alibeknakhimov/Naiza-Boxer/hardware/controller-board/PCB_NAIZA_CONTROLLER.png

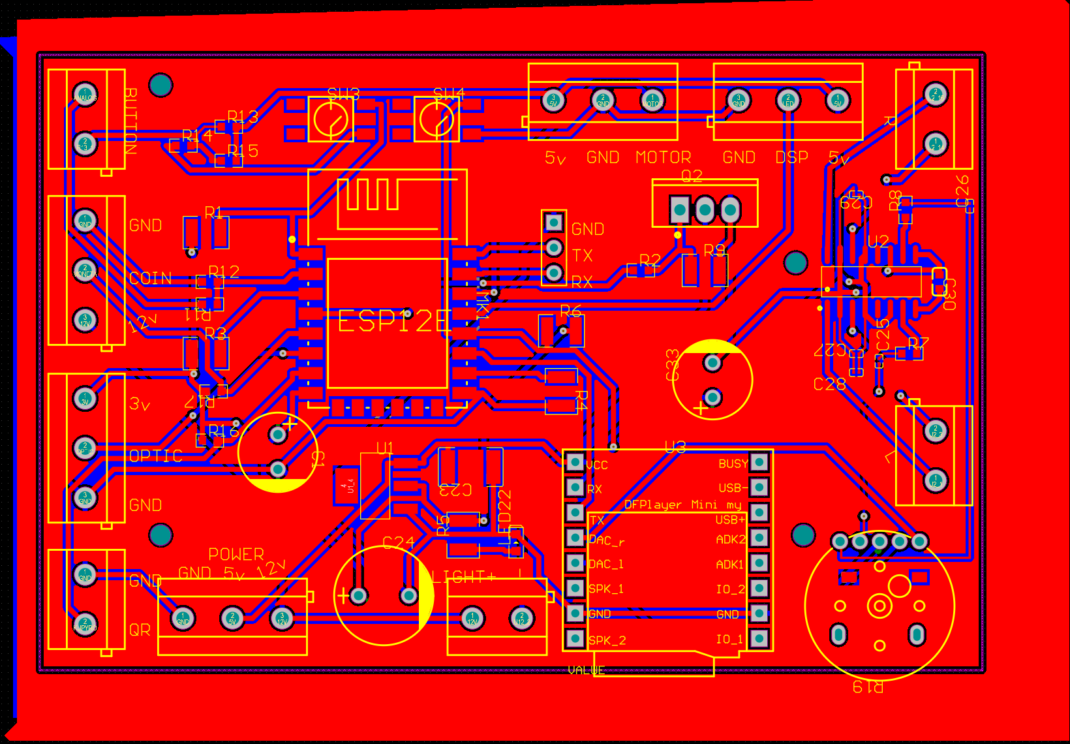
hardware/controller-board/PCB_NAIZA_CONTROLLER.png
