alibeknakhimov/Naiza-Boxer/hardware/display-board/PCB_boxDisp.png

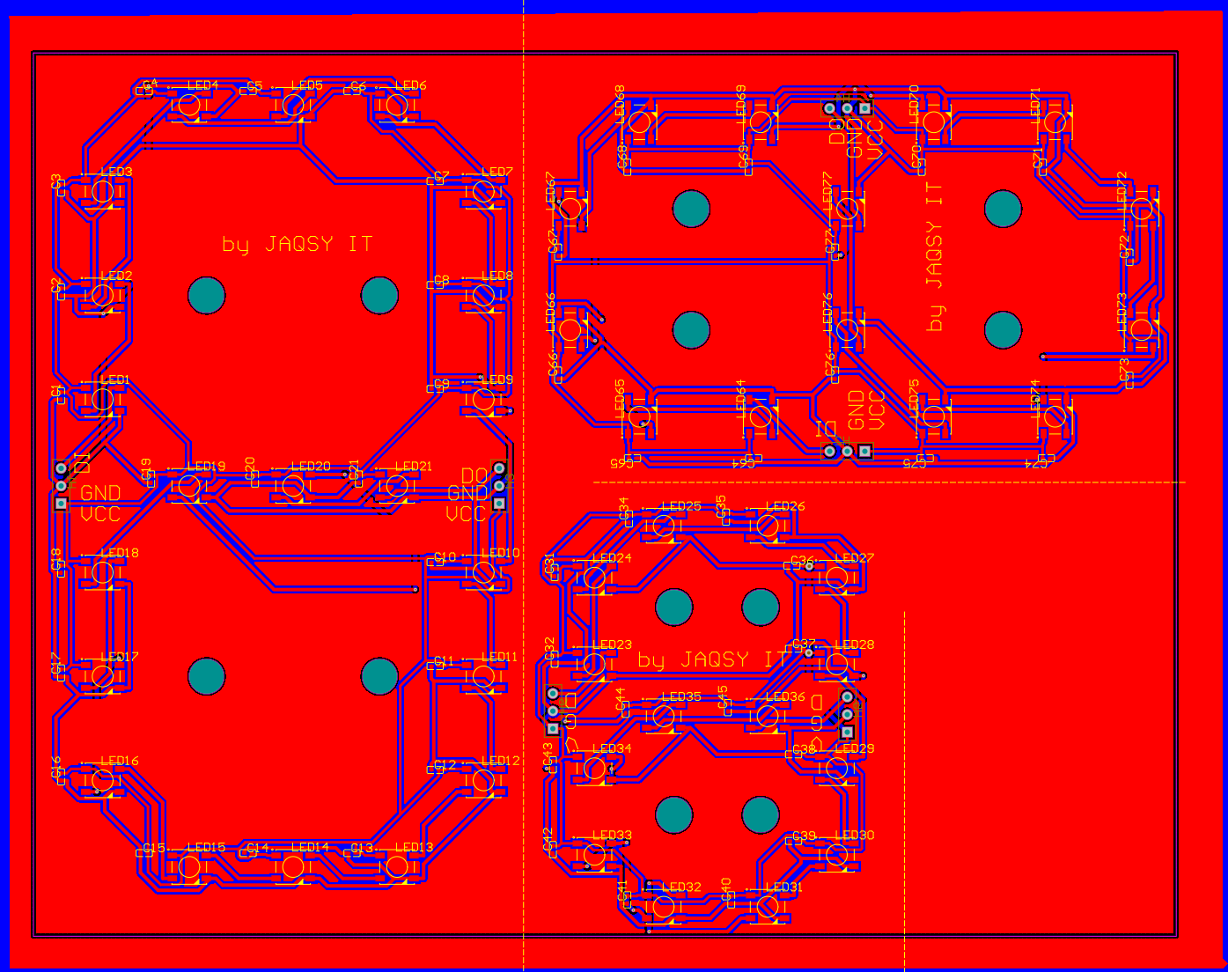
hardware/display-board/PCB_boxDisp.png
