alibeknakhimov/Naiza-Boxer/media/photos/3F5CE515-B64C-4980-AA3E-3DC91DD8F0C6.jpg

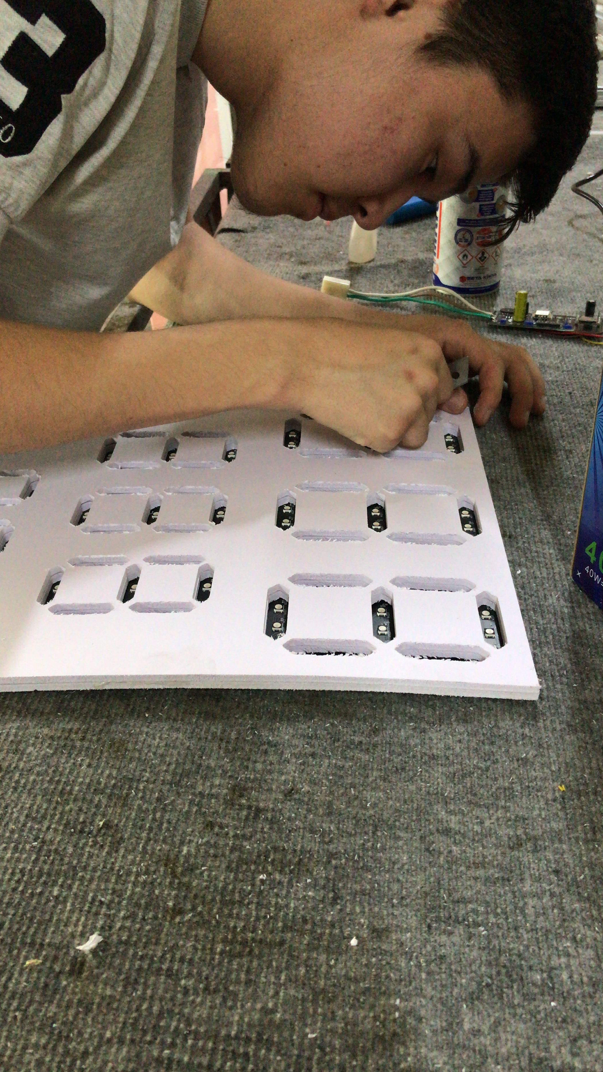
media/photos/3F5CE515-B64C-4980-AA3E-3DC91DD8F0C6.jpg
