alibeknakhimov/Naiza-Boxer/media/photos/20220618_153551.jpg

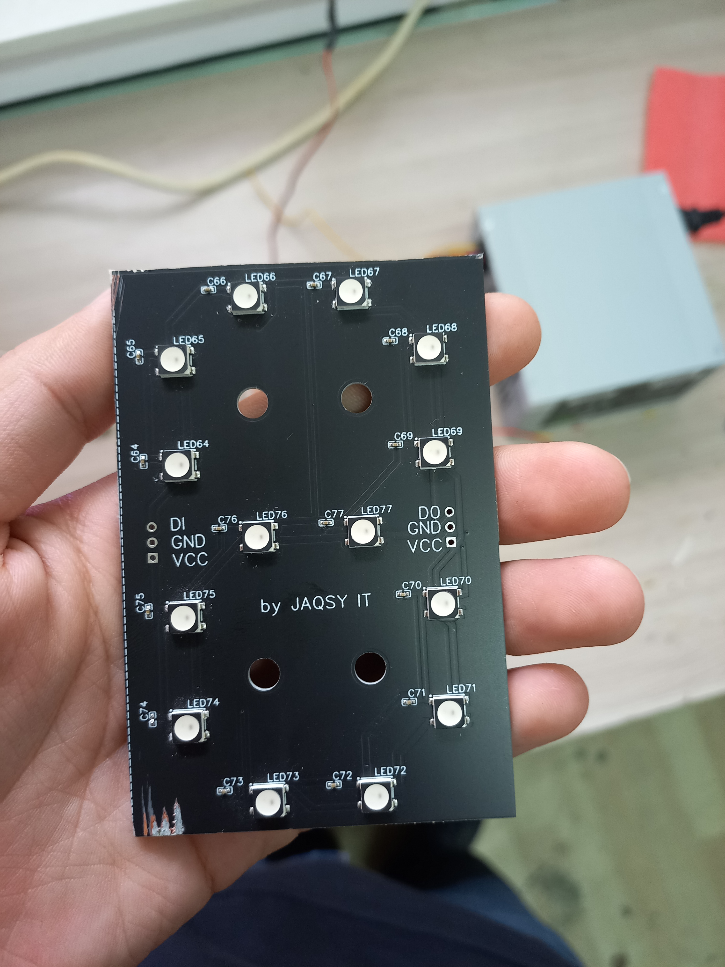
media/photos/20220618_153551.jpg
