alibeknakhimov/Naiza-Boxer/media/photos/20220618_153646.jpg

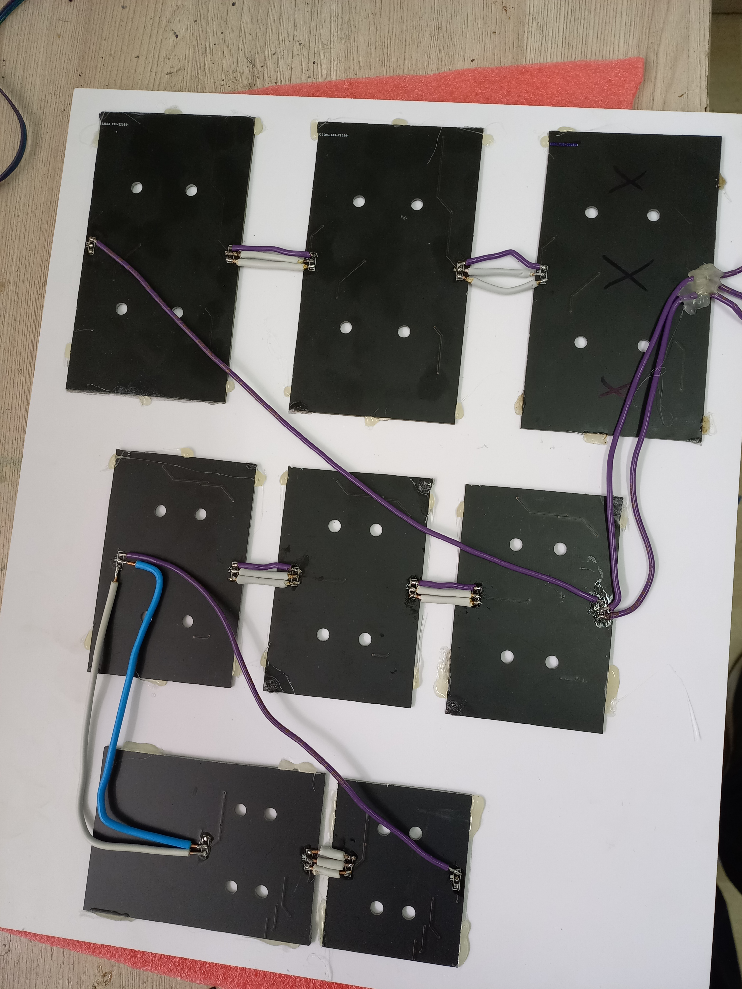
media/photos/20220618_153646.jpg
