alibeknakhimov/Naiza-Boxer/media/photos/AF380AF1-BA0E-4150-B0BB-21EFCCC5D488.jpg

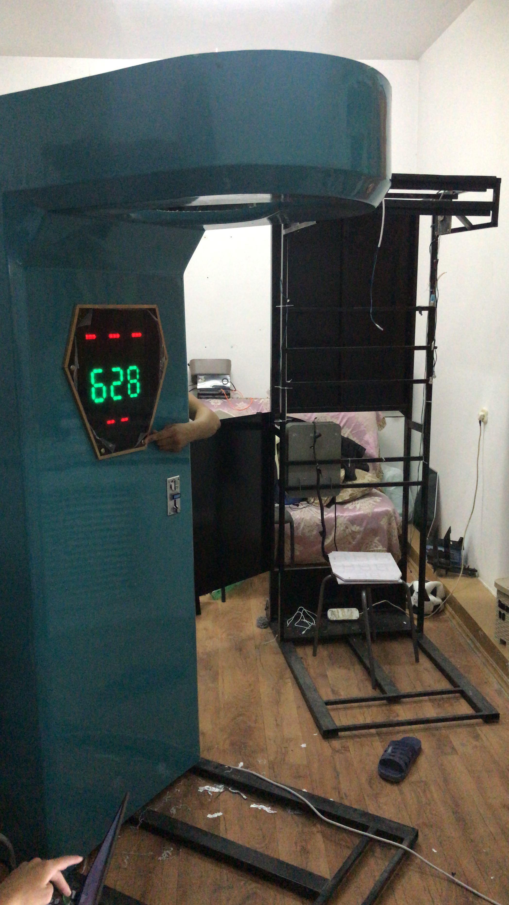
media/photos/AF380AF1-BA0E-4150-B0BB-21EFCCC5D488.jpg
