alibeknakhimov/Naiza-Boxer/media/photos/IMG-20220126-WA0025.jpg

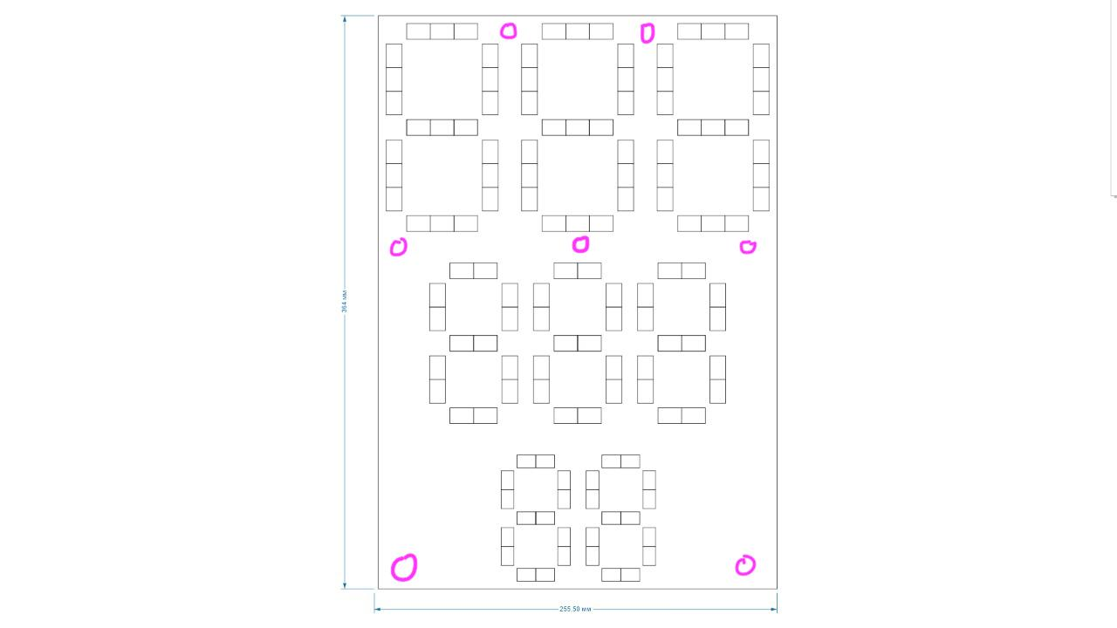
media/photos/IMG-20220126-WA0025.jpg
