alibeknakhimov/Naiza-Boxer/media/photos/IMG-20220317-WA0033.jpg

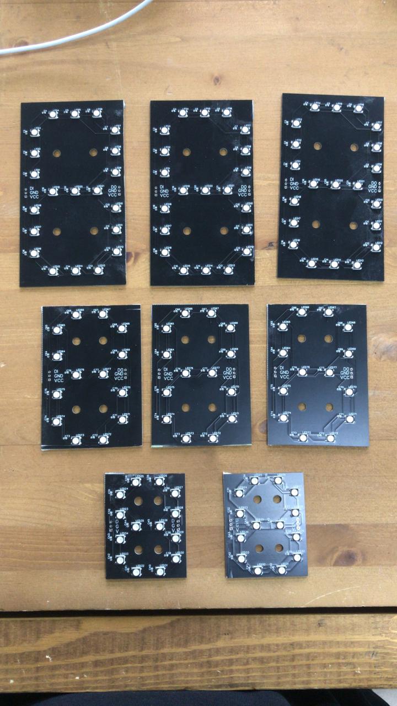
media/photos/IMG-20220317-WA0033.jpg
