alibeknakhimov/Naiza-Boxer/media/photos/IMG-20220427-WA0114.jpeg

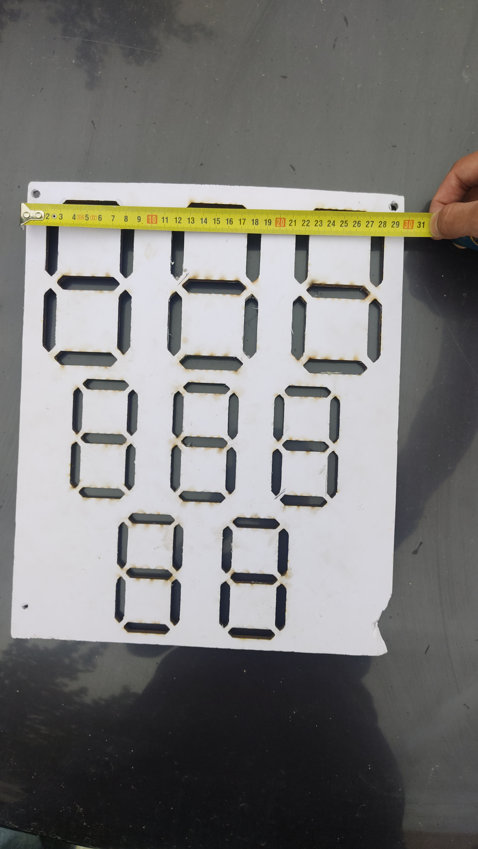
media/photos/IMG-20220427-WA0114.jpeg
