alibeknakhimov/Naiza-Boxer/media/photos/IMG-20220427-WA0122.jpeg

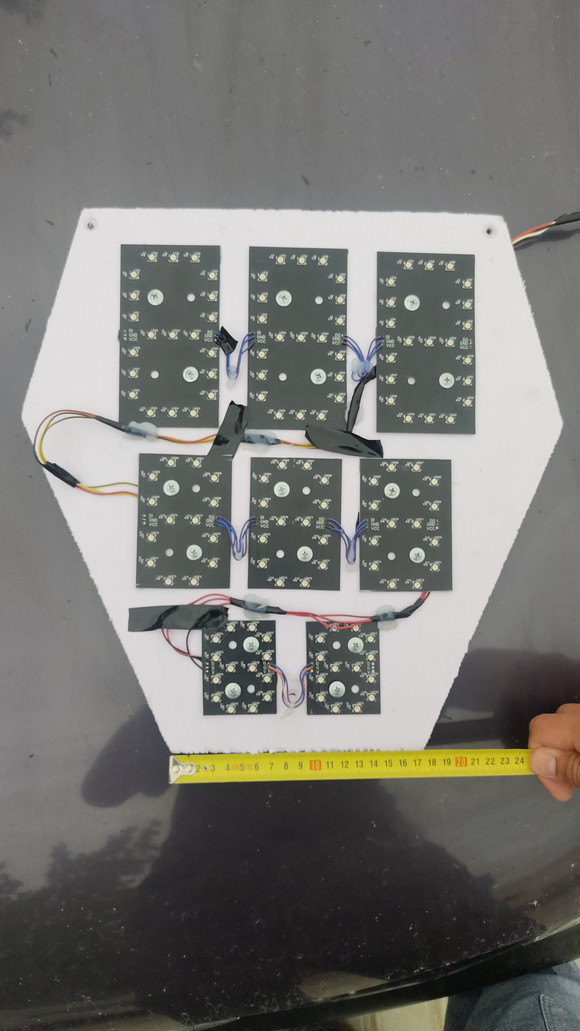
media/photos/IMG-20220427-WA0122.jpeg
