alibeknakhimov/Naiza-Boxer/media/photos/IMG-20220718-WA0063.jpg

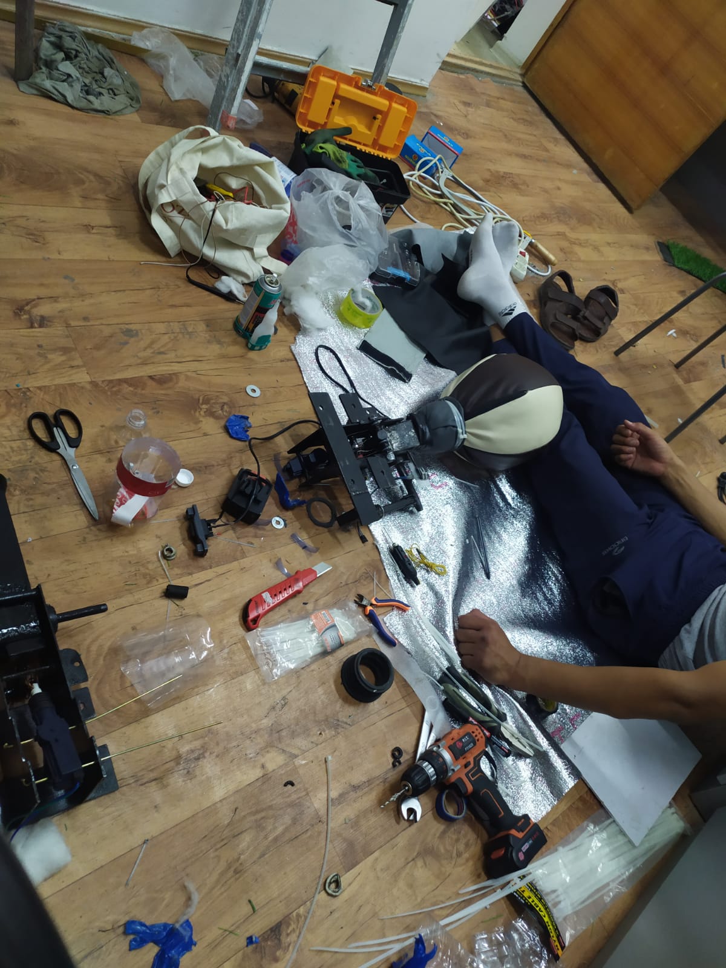
media/photos/IMG-20220718-WA0063.jpg
