alibeknakhimov/Naiza-Boxer/media/photos/IMG-20230116-WA0098.jpg

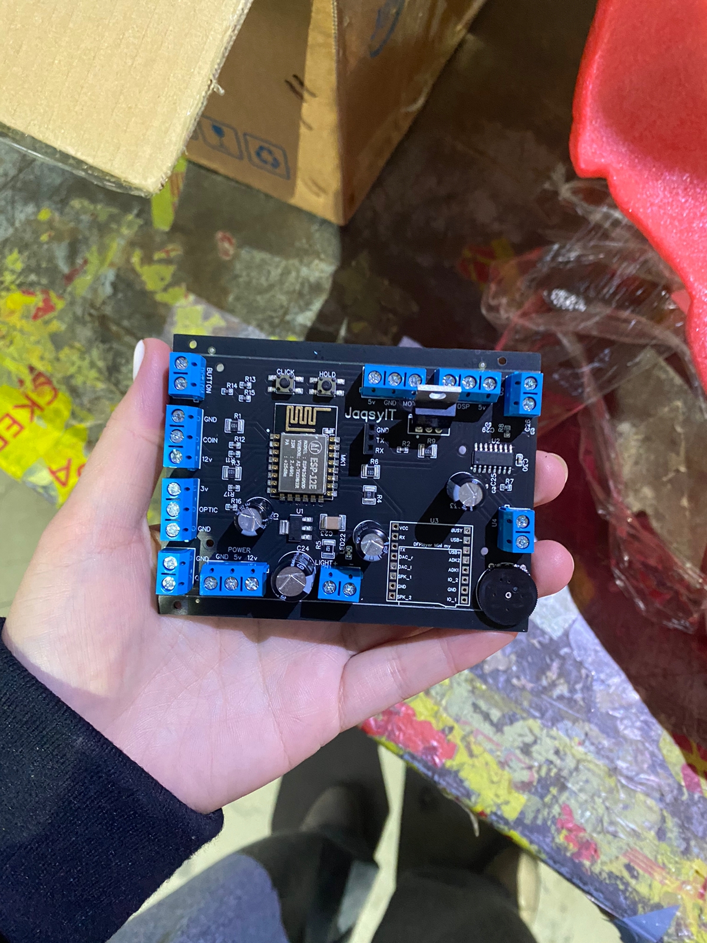
media/photos/IMG-20230116-WA0098.jpg
