alibeknakhimov/Naiza-Boxer/media/photos/IMG_2034.jpg

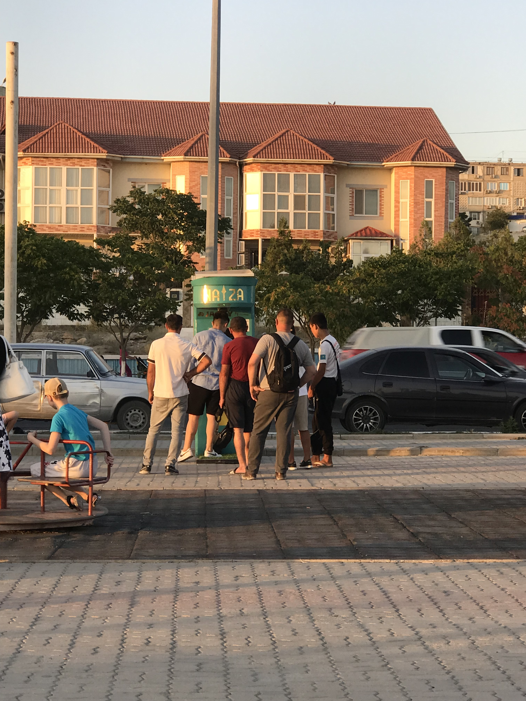
media/photos/IMG_2034.jpg
