alibeknakhimov/Naiza-Boxer/media/photos/IMG_3334.jpg

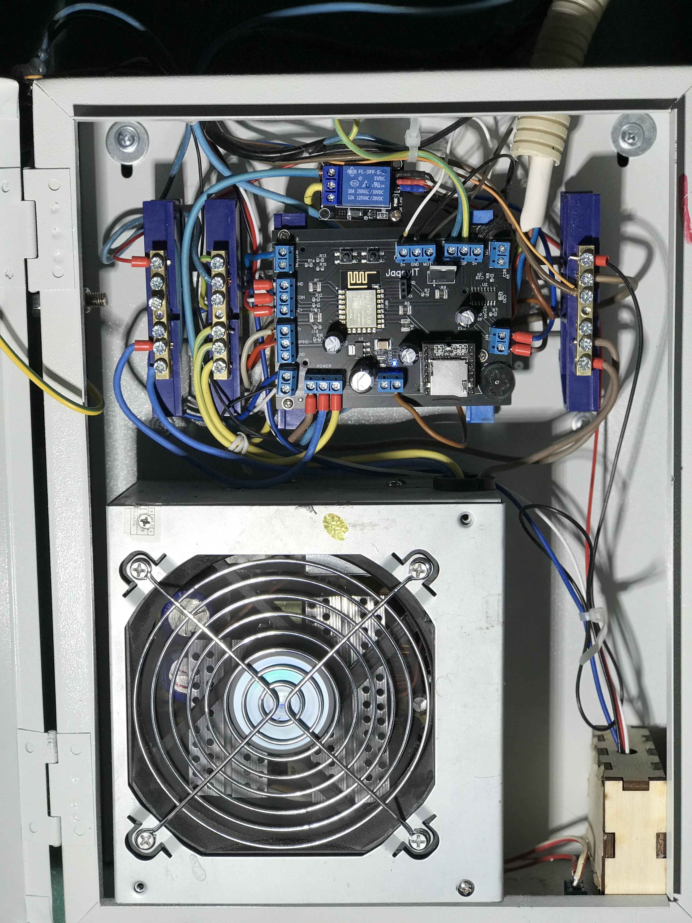
media/photos/IMG_3334.jpg
