alibeknakhimov/Naiza-Boxer/media/photos/IMG_20230424_165639.jpg

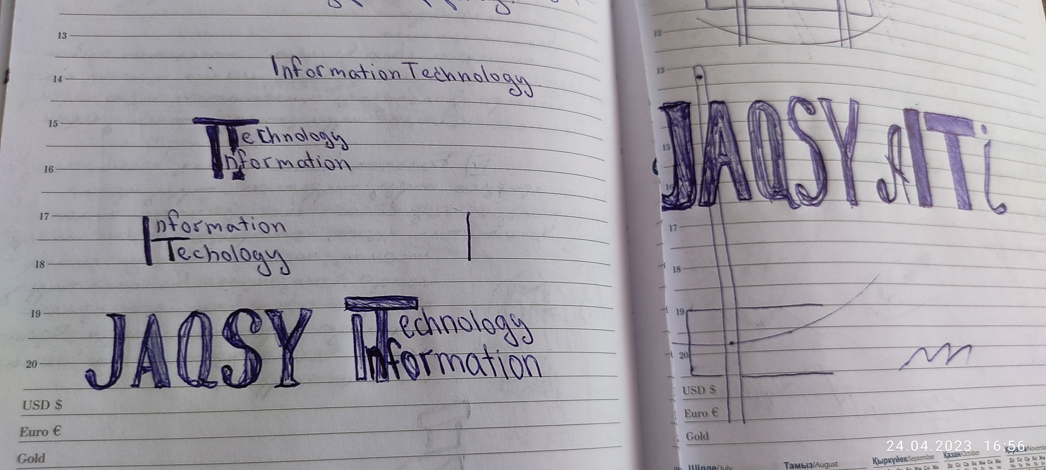
media/photos/IMG_20230424_165639.jpg
