alibeknakhimov/Naiza-Boxer/hardware/controller-board/BOM_NAIZA_CONTROLLER.csv

ID | Name | Designator | Footprint | Quantity | Manufacturer Part | Manufacturer | Supplier | Supplier Part | Price
1 | 10uF | C23 | C1812 | 1 | C4532X7R1H106K | TDK | LCSC | C18733 | 0.477
2 | 1000uF | C24 | CAP-TH_BD10.0-P5.00-D1.0-FD | 1 | 16PX1000MEFC10X12.5 | Rubycon | LCSC | C88777 | 0.234
3 | 470nF | C25,C26 | C0201 | 2 | C0201X5R474M6R3NTJ | Shenzhen Eyang Tech Development | LCSC | C115582
4 | 1uF | C27,C28,C29 | C0201 | 3 | GRM033R61A105ME15D | Murata Electronics | LCSC | C181054 | 0.026
5 | 100nF | C30 | C0603 | 1 | CL10B104KB8NNNC | SAMSUNG | LCSC | C1591 | 0.003
6 | 470uF | C33 | CAP-TH_BD8.0-P3.50-D0.6-FD | 1 | 16ZL470MEFC8X16 | Rubycon | LCSC | C428696 | 0.134
7 | LED-0603_B | LED22 | LED0603_BLUE | 1 | 19-217/BHC-ZL1M2RY/3T | EVERLIGHT(台湾亿光) | LCSC | C72041 | 0.023
8 | ESP-12E | MK1 | WIFIM-SMD_ESP-12E-BR | 1 | ESP-12E | Ai-Thinker | LCSC | C89297 | 2.908
9 | 10K | R1,R3,R4,R6,R9 | R1210 | 5 | RK73B2ETTD103J | KOA | LCSC | C131365 | 0.04
10 | 330 | R5 | R1210 | 1 | RC1210JR-071KL | YAGEO | LCSC | C114690 | 0.01
11 | 10K | R7,R8 | R0603 | 2 | RC0603FR-0710KL | YAGEO | LCSC | C98220 | 0.001
12 | 220 | R11,R13,R14,R15 | R0603 | 4 | 0603WAF2200T5E | UniOhm | LCSC | C22962 | 0.001
13 | 100 | R12,R2 | R0603 | 2 | 0603WAF1000T5E | UniOhm | LCSC | C22775 | 0.001
14 | 4.7k | R16 | R0603 | 1 | 0603WAF4701T5E | UniOhm | LCSC | C23162 | 0.001
15 | 10k | R17 | R0603 | 1 | 0603WAF1002T5E | UniOhm | LCSC | C25804 | 0.001
16 | 50K | R19 | RES-TH_RK14J12A0A0K | 1 | RK14J12A0A0K | ALPS Electric | LCSC | C351177 | 1.037
17 | TS4548TP | SW3,SW4 | KEY-SMD_4P-L4.5-W4.5-P3.00-LS7.0 | 2 | TS4548TP | SHOU HAN(首韩) | LCSC | C2681489 | 0.02
18 | AMS1117-3.3 | U1 | SOT-223-3_L6.5-W3.4-P2.30-LS7.0-BR | 1 | AMS1117-3.3 | AMS | LCSC | C6186 | 0.182
19 | PAM8403DR | U2 | SOIC-16_L9.9-W3.9-P1.27-LS6.0-BL | 1 | PAM8403DR | DIODES | LCSC | C17337 | 0.47
20 | DFPLAYER_03 | U3 | DFPLAYER | 1 | DFPLAYER
21 | L | L | CONN-TH_P5.00_KF301-5.0-2P | 1 | KF301-5.0-2P | Cixi Kefa Elec | LCSC | C474881 | 0.086
22 | R | R | CONN-TH_P5.00_KF301-5.0-2P | 1 | KF301-5.0-2P | Cixi Kefa Elec | LCSC | C474881 | 0.086
23 | BUTTON | U6 | CONN-TH_P5.00_KF301-5.0-2P | 1 | KF301-5.0-2P | Cixi Kefa Elec | LCSC | C474881 | 0.086
24 | DISPLAY | U8 | CONN-TH_3P-P5.00_KF301-5.0-3P | 1 | KF301-5.0-3P | Cixi Kefa Elec | LCSC | C474882 | 0.12
25 | SENSOR | U9 | CONN-TH_3P-P5.00_KF301-5.0-3P | 1 | KF301-5.0-3P | Cixi Kefa Elec | LCSC | C474882 | 0.12
26 | COIN | U10 | CONN-TH_3P-P5.00_KF301-5.0-3P | 1 | KF301-5.0-3P | Cixi Kefa Elec | LCSC | C474882 | 0.12
27 | RELAY | U11 | CONN-TH_3P-P5.00_KF301-5.0-3P | 1 | KF301-5.0-3P | Cixi Kefa Elec | LCSC | C474882 | 0.12
28 | IRLB8748PBF | Q2 | TO-220-3_L10.0-W4.5-P2.54-L | 1 | IRLB8748PBF | Infineon | LCSC | C151540 | 0.671
29 | LIGHTS | U12 | CONN-TH_P5.00_KF301-5.0-2P | 1 | KF301-5.0-2P | Cixi Kefa Elec | LCSC | C474881 | 0.086
30 | CASH | U13 | CONN-TH_P5.00_KF301-5.0-2P | 1 | KF301-5.0-2P | Cixi Kefa Elec | LCSC | C474881 | 0.086
31 | 100uF | C1 | CAP-TH_BD8.0-P3.50-D0.6-FD | 1 | 50YXJ100M8X11.5 | rubycon(红宝石) | LCSC | C88859 | 0.077
32 | POWER | U7 | CONN-TH_3P-P5.00_KF301-5.0-3P | 1 | KF301-5.0-3P | Cixi Kefa Elec | LCSC | C474882 | 0.12
33 | HDR-F-2.54_1x3 | H1 | HDR-F-2.54_1X3 | 1 |  |  | LCSC | C146690 | 0.086
