alibeknakhimov/Naiza-Boxer/hardware/display-board/BOM_NAIZA_DISPLAY.csv

ID | Name | Designator | Footprint | Quantity | Manufacturer Part | Manufacturer | Supplier | Supplier Part | Price
1 | HDR-F-2.54_1x3 | H2,H1,H3,H4,H5,H6 | HDR-F-2.54_1X3 | 6 | 22025403P00CKMT | Ckmtw | LCSC | C146690 | 0.086
2 | 100nF | C1,C2,C3,C4,C5,C6,C7,C8,C9,C10,C11,C12,C13,C14,C15,C16,C17,C18,C19,C20,C21,C31,C32,C34,C35,C36,C37,C38,C39,C40,C41,C42,C43,C44,C45,C64,C65,C66,C67,C68,C69,C70,C71,C72,C73,C74,C75,C76,C77 | C0402 | 49 | GRM022R60J104KE15D | Murata Electronics | LCSC | C161362 | 0.003
3 | WS2812B-B | LED1,LED2,LED3,LED4,LED5,LED6,LED7,LED8,LED9,LED10,LED11,LED12,LED13,LED14,LED15,LED16,LED17,LED18,LED19,LED20,LED21,LED64,LED65,LED66,LED67,LED68,LED69,LED70,LED71,LED72,LED73,LED74,LED75,LED76,LED77,LED23,LED24,LED25,LED26,LED27,LED28,LED29,LED30,LED31,LED32,LED33,LED34,LED35,LED36 | LED-SMD_4P-L5.0-W5.0-TL_WS2812B-B | 49 | WS2812B-B | Worldsemi | LCSC | C114586 | 0.083
