alibeknakhimov/Naiza-Boxer/hardware/controller-board/Schematic_NAIZA_CONTROLLER.pdf

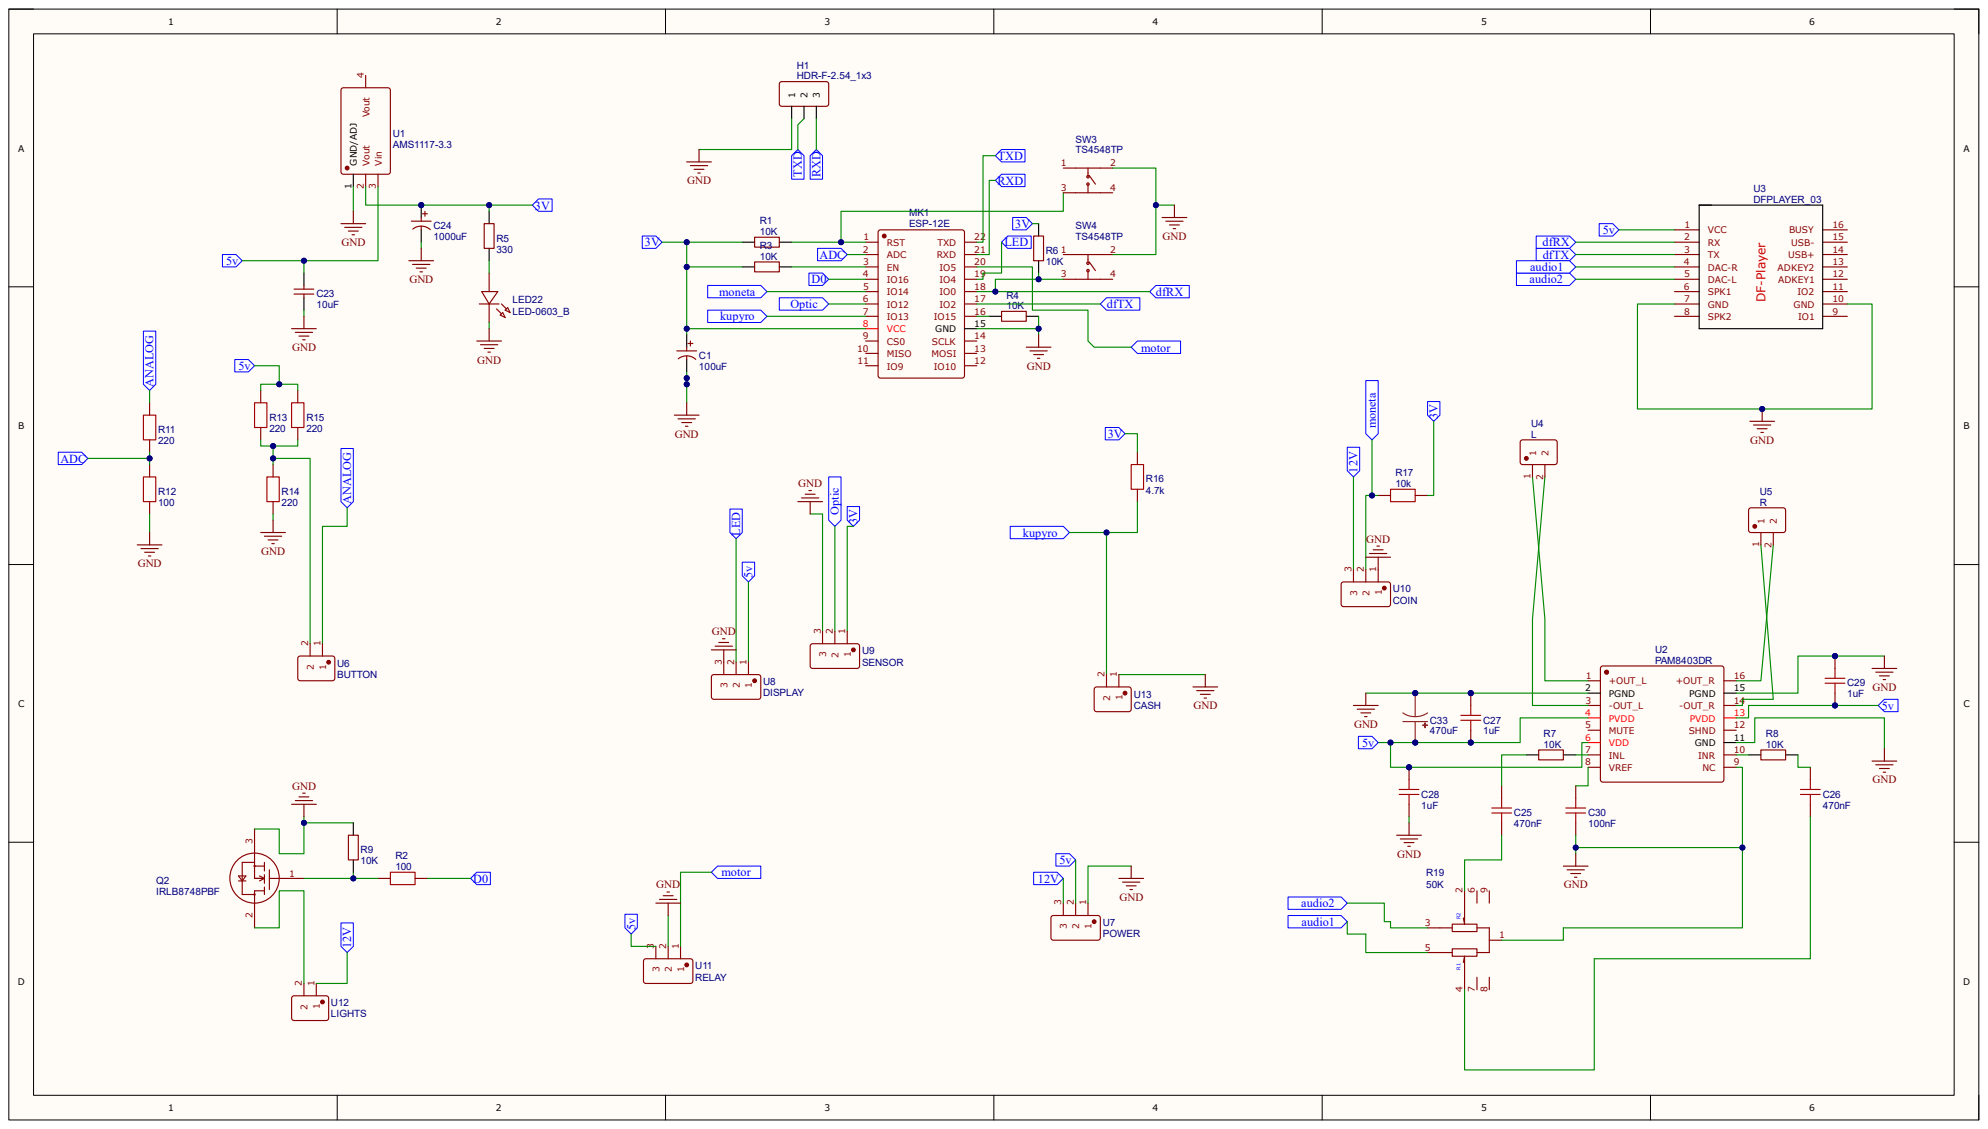
[picture p18: page 1]

10K GND/ADJ 1 Vout 2 Vin 3 Vout 4
