alibeknakhimov/Naiza-Boxer/hardware/display-board/Schematic_NAIZA_DISPLAY.pdf

### vcc1 gnd1

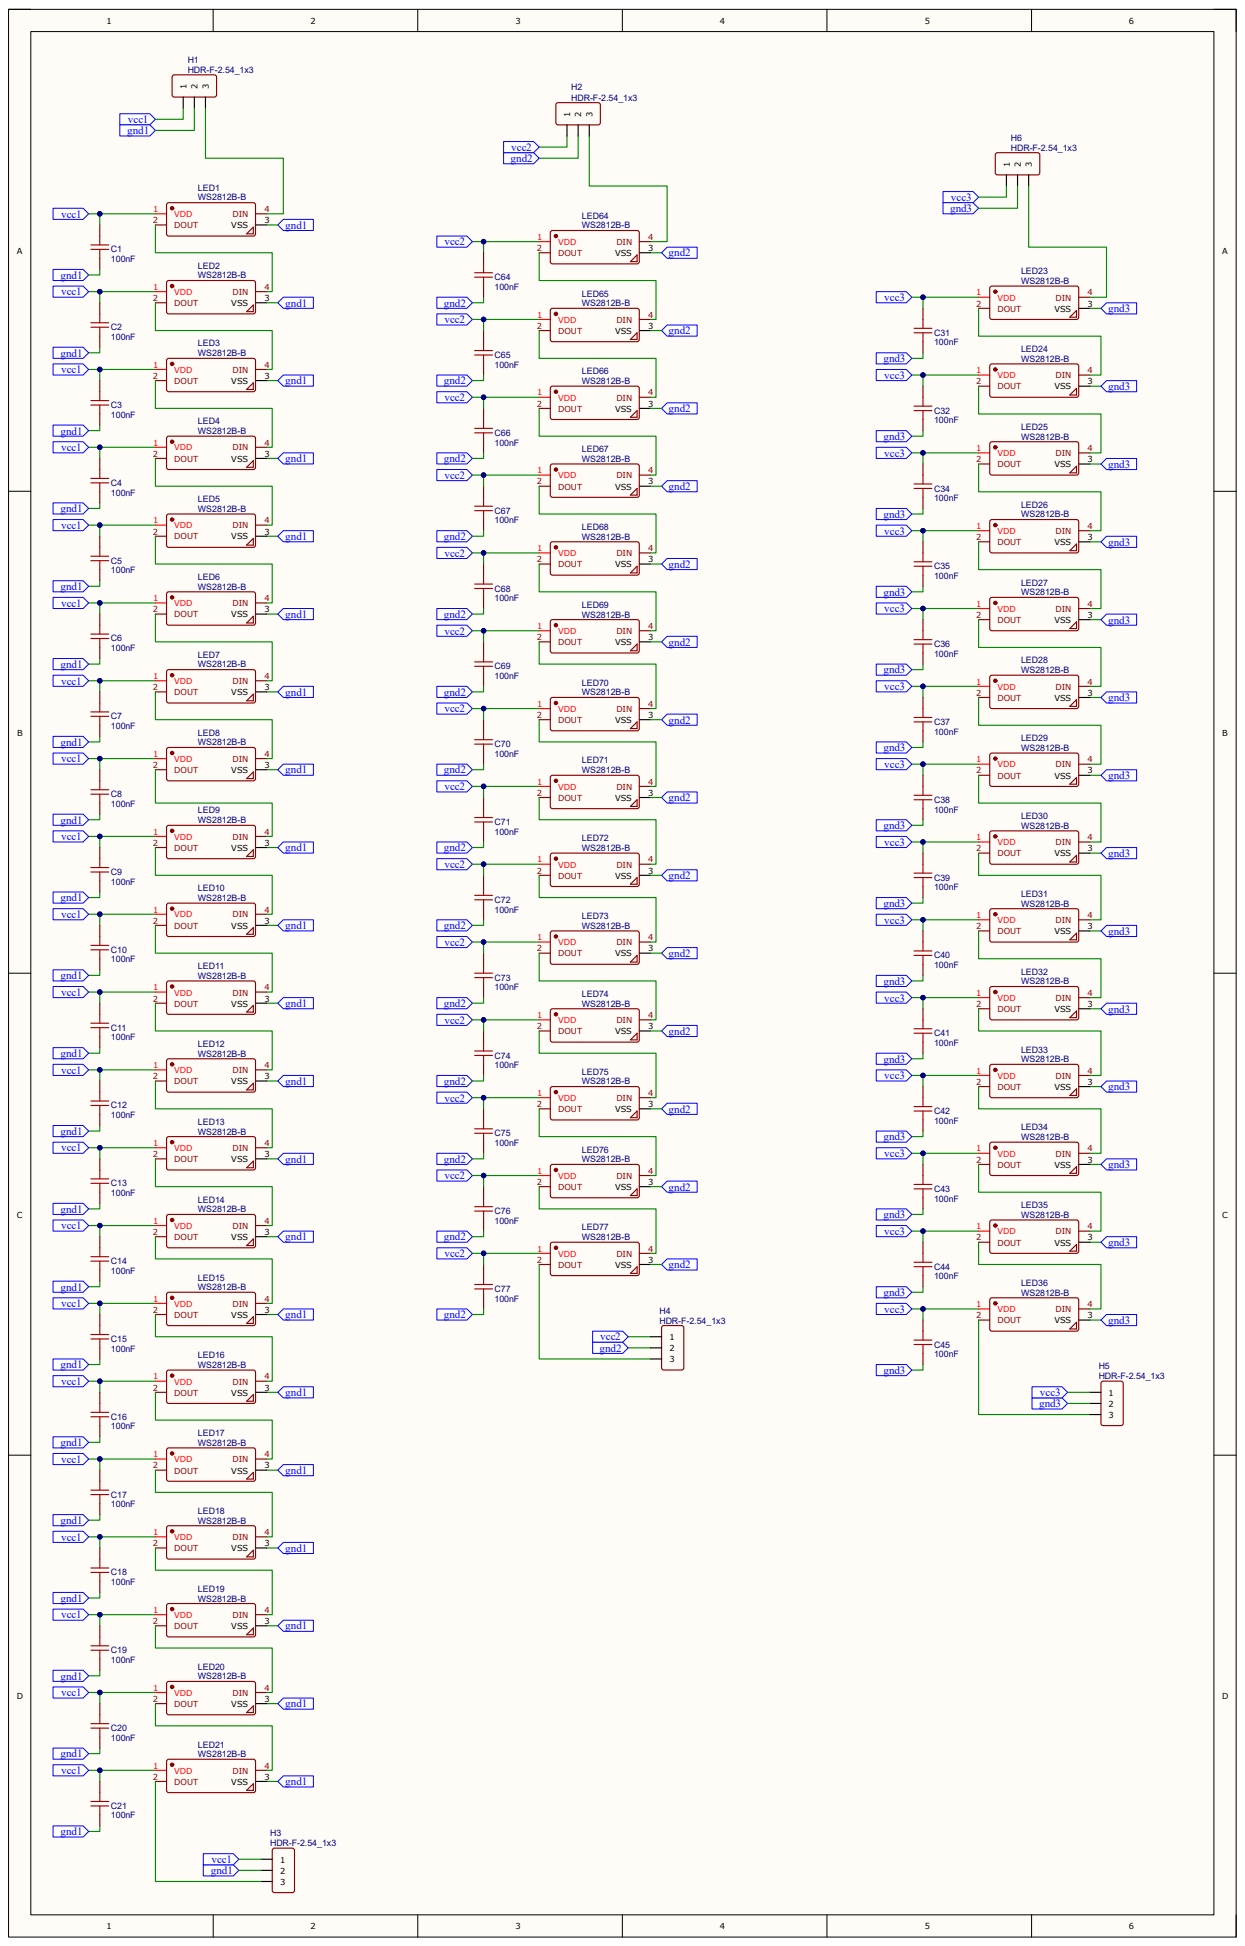
[picture p19: page 1]
